krompirate6149/PC-Gauge-Cluster/models/dial.stl

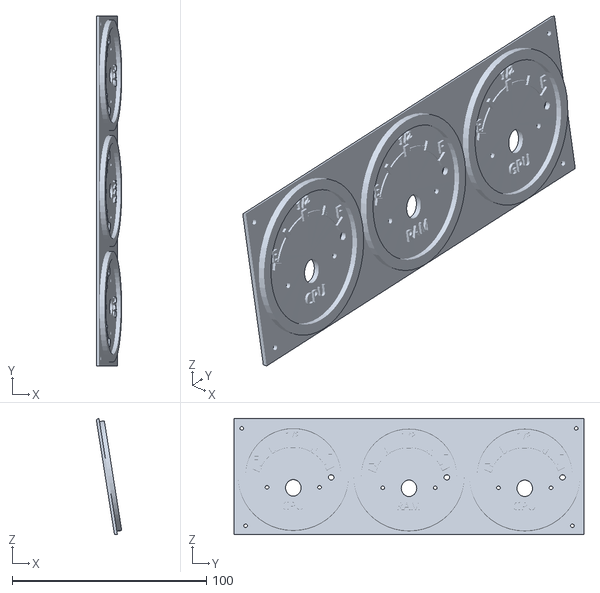
[picture p1: CAD file, 2026-10-28]
models/dial.stl
13.1 x 180.0 x 59.8
