krompirate6149/PC-Gauge-Cluster/models/Cover.stl

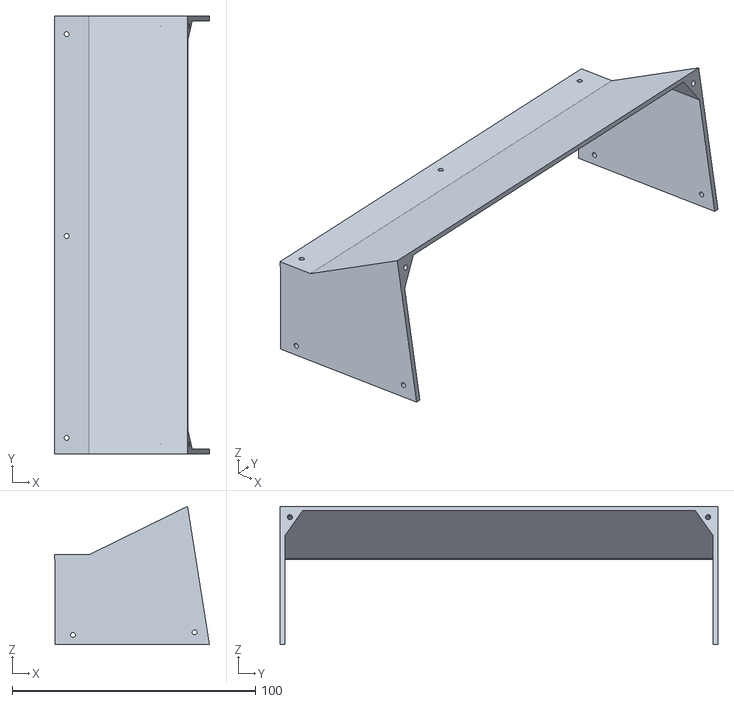
[picture p2: CAD file, 2026-10-28]
models/Cover.stl
63.7 x 180.0 x 56.9
