krompirate6149/PC-Gauge-Cluster/models/Needle_Boss.stl

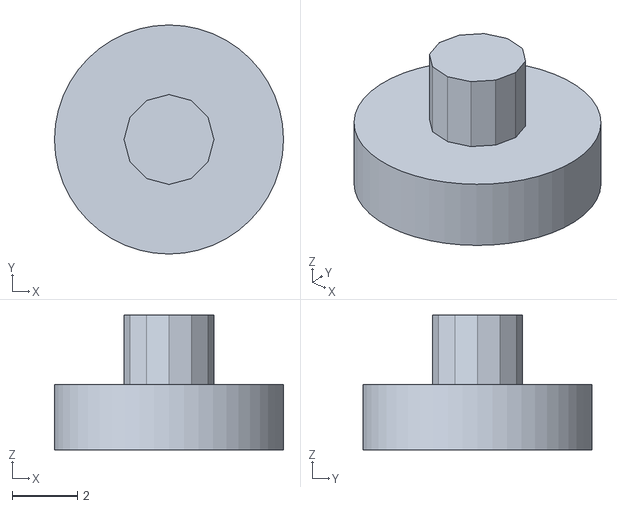
[picture p3: CAD file, 2026-10-28]
models/Needle_Boss.stl
7.00 x 7.00 x 4.12
