krompirate6149/PC-Gauge-Cluster/models/Gauge_Needle.stl

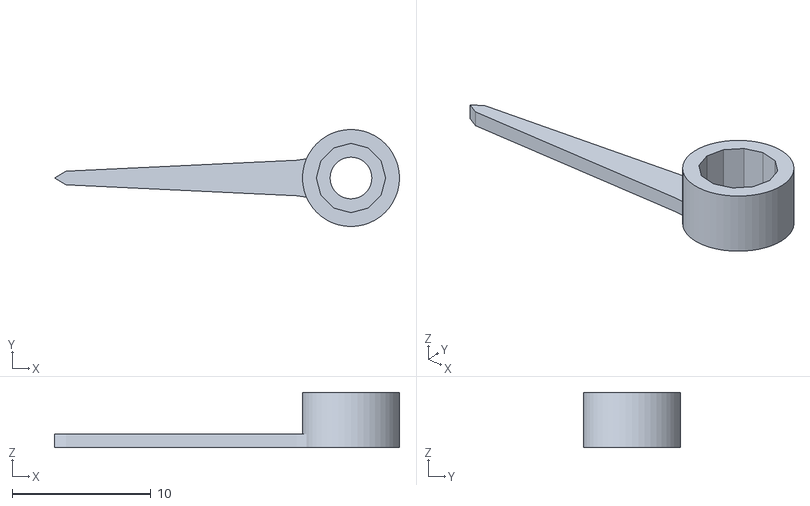
[picture p4: CAD file, 2026-10-28]
models/Gauge_Needle.stl
24.9 x 7.00 x 4.00
