krompirate6149/PC-Gauge-Cluster/models/Base.stl

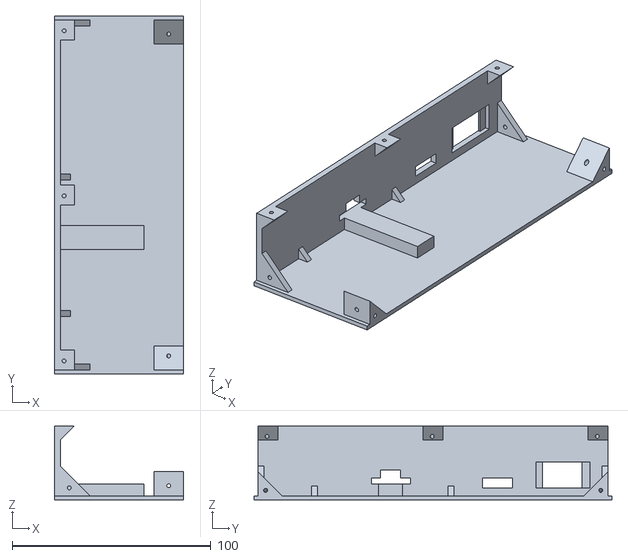
[picture p5: CAD file, 2026-10-28]
models/Base.stl
65.0 x 180.0 x 37.0
