krompirate6149/PC-Gauge-Cluster/models/Servo_Mount.stl

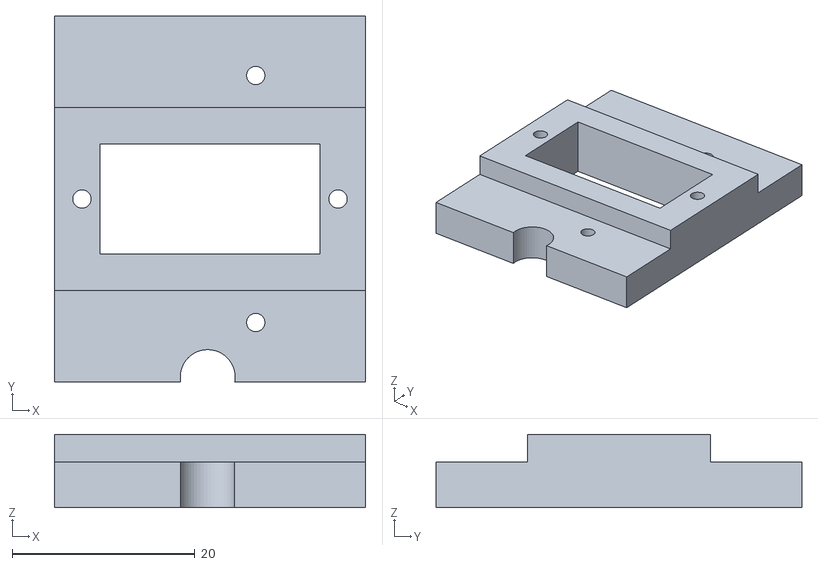
[picture p6: CAD file, 2026-10-28]
models/Servo_Mount.stl
34.0 x 40.0 x 8.00
