krompirate6149/PC-Gauge-Cluster/(commit log)

2026-10-28 Update README with LED connections and power instructions
    Added LED connections and updated power connection instructions.
2026-10-28 Update hardware requirements to include Arduino Nano
2026-10-28 Add LED wiring instructions
    Added wiring instructions for three LEDs to the README.
2026-10-28 Update README with LED wiring instructions
    Added wiring instructions for LEDs and power connections.
2026-10-28 Add new STL files and update models section
